samvandenabeele/CanSat/MARKDOWN.md

BMP280:
- I2C adress: 0x77
- C_max: 1.12 mA

RFM69HCW:
- 150 mA
- SPI:
	- RST: GP3
	- MOSI: GP7
	- MISO: GP6
	- SCK: GP4
	- NSS: GP5

MPU6050:
- I2C adress: 0x68
- C_max: 4 mA

TMP36:
- ADC: GP26
- C_max: 50 micro-A

SGP30:
- I2C adress: 0x58
- 50 mA

general I2C:
- I2C SDA: GP0
- I2C SCL: GP1

max battery current: 1 A
peak current draw: 955,12 mA
expected average current draw: 600-700 mA
