samvandenabeele/CanSat/cansat-pcb/cansat pcb.pdf

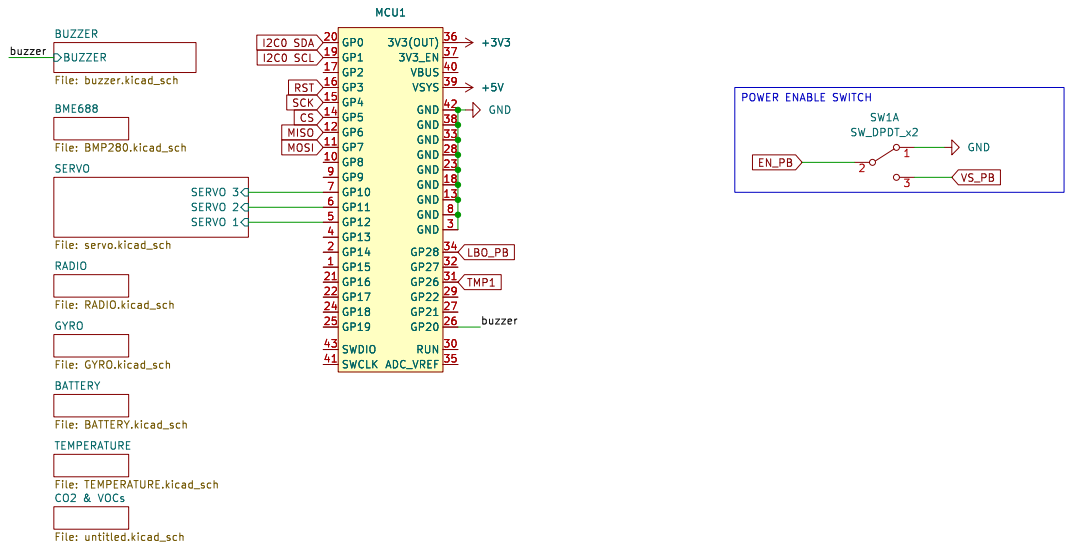
[picture p1: page 1]

I2C0 SDA RST SCK MISO
I2C0 SCL CS

File: RADIO.kicad_sch CO2 & VOCs File: untitled.kicad_sch BATTERY

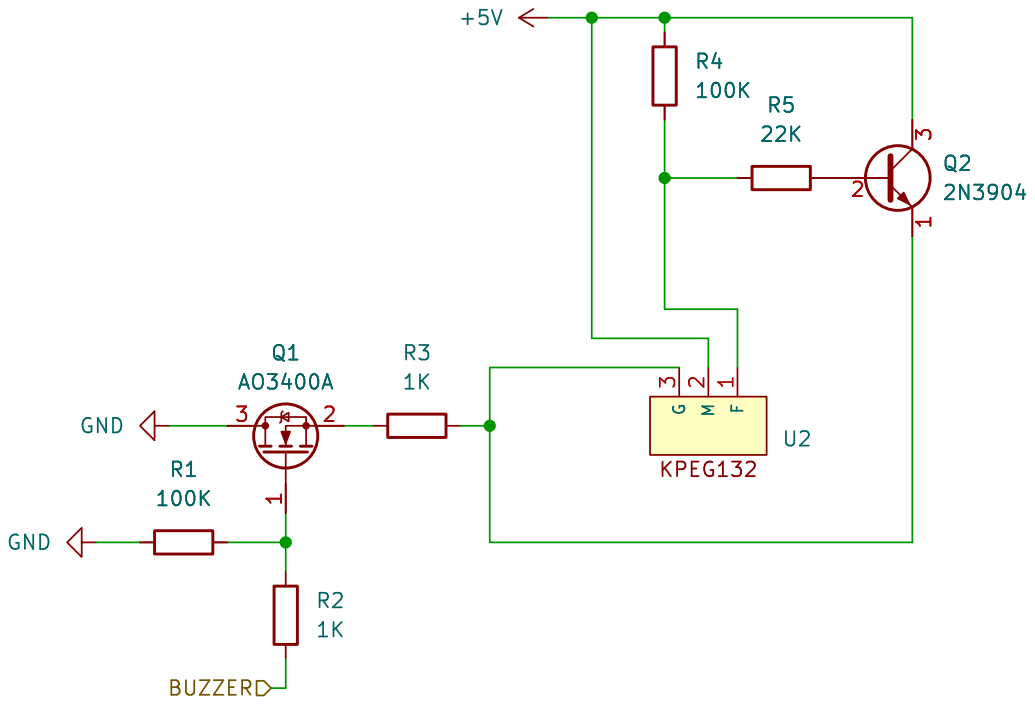
[picture p2: page 2]

Id: 2/9 Title: File: buzzer.kicad_sch Sheet: /BUZZER/

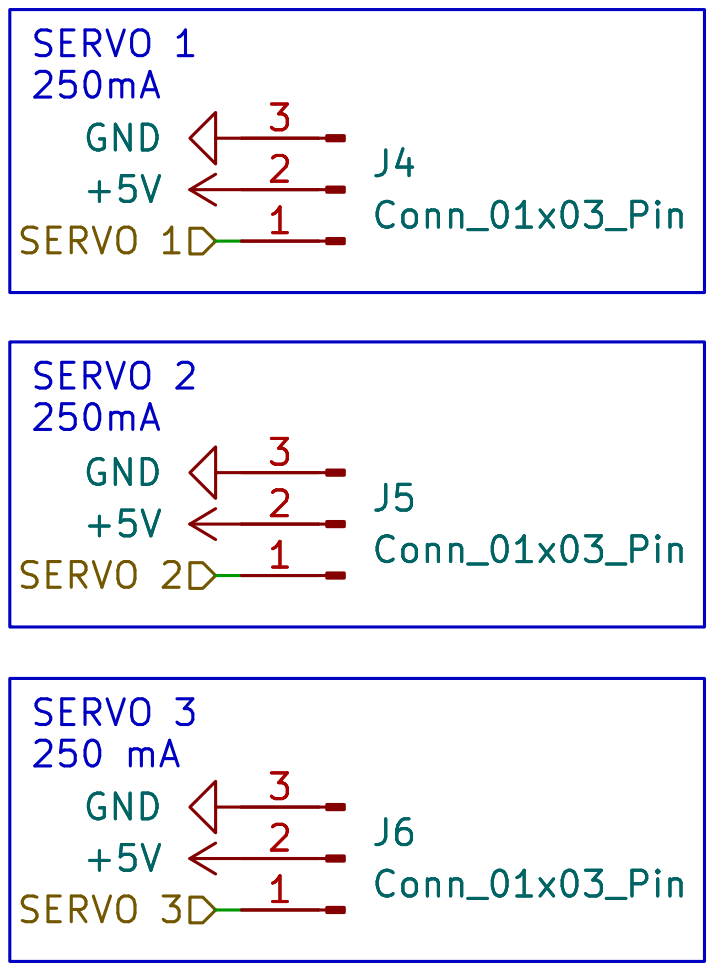
[picture p3: page 3]

J6Conn_01x03_Pin SERVO 1 SERVO 2 SERVO 3 SERVO 1

Id: 3/9 Title: File: servo.kicad_sch Sheet: /SERVO/

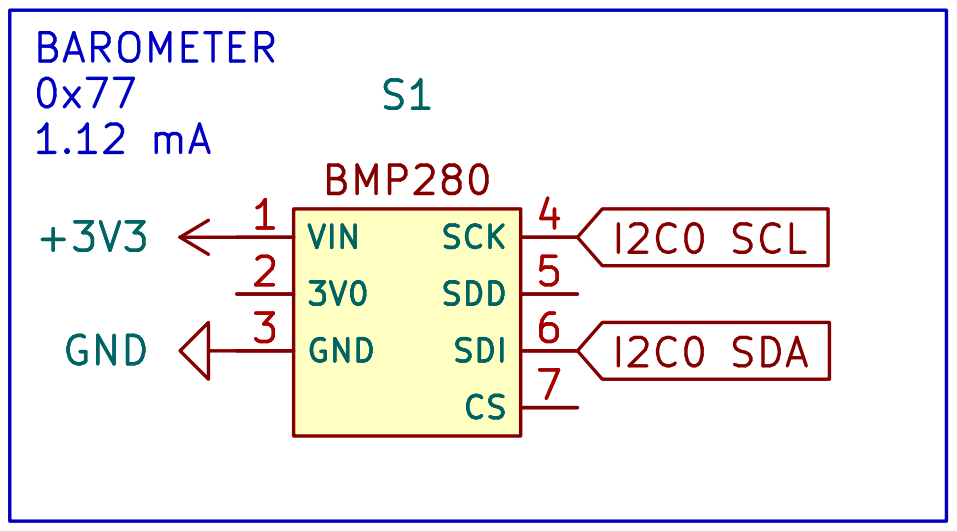
[picture p4: page 4]

Id: 4/9 Title: File: BMP280.kicad_sch Sheet: /BME688/ GND

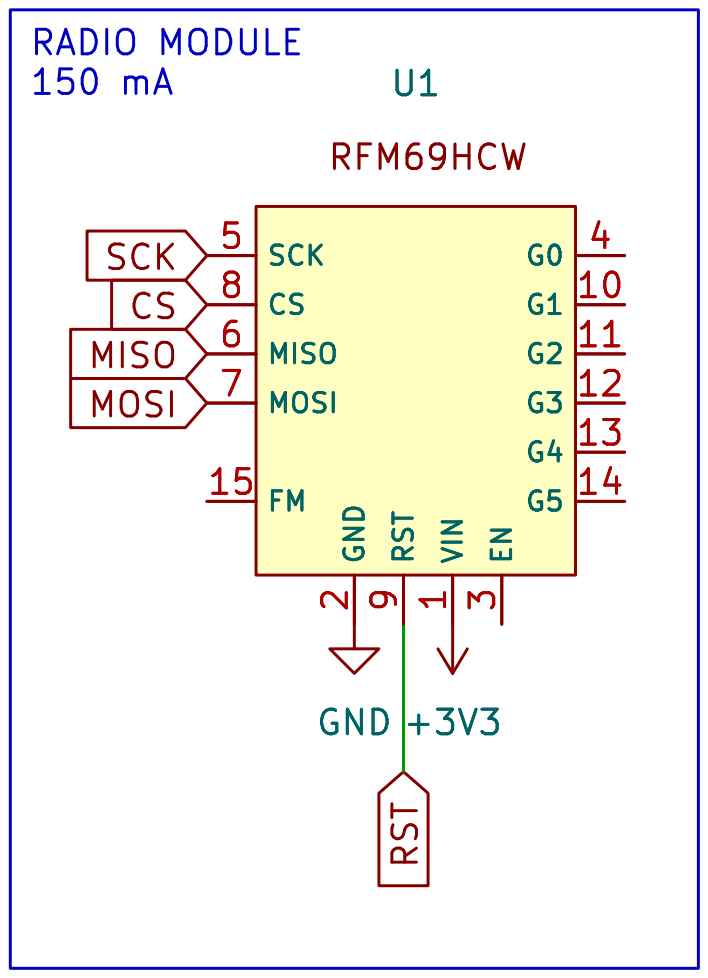
[picture p5: page 5]

CS MOSI RADIO MODULE

Id: 5/9 Title: File: RADIO.kicad_sch Sheet: /RADIO/ GND +3V3 RFM69HCWVIN

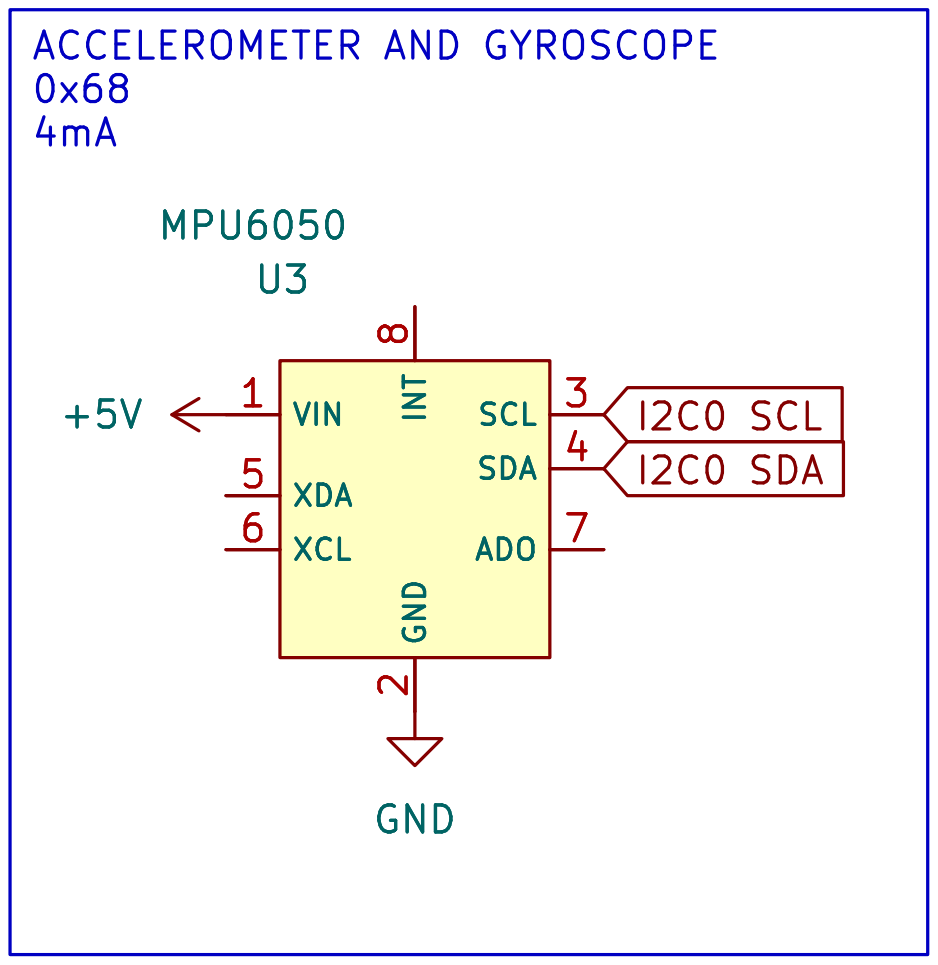
[picture p6: page 6]

I2C0 SCL ACCELEROMETER AND GYROSCOPE

Id: 6/9 Title: File: GYRO.kicad_sch Sheet: /GYRO/

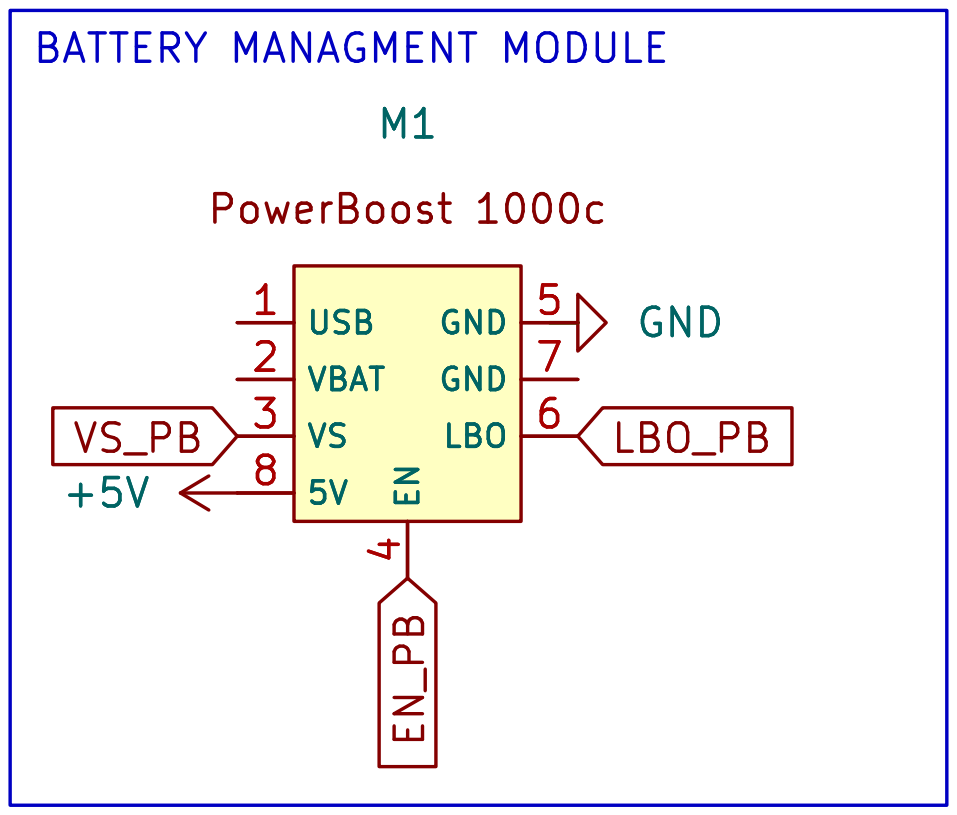
[picture p7: page 7]

BATTERY MANAGMENT MODULE M1 USB 1

Id: 7/9 Title: File: BATTERY.kicad_sch Sheet: /BATTERY/

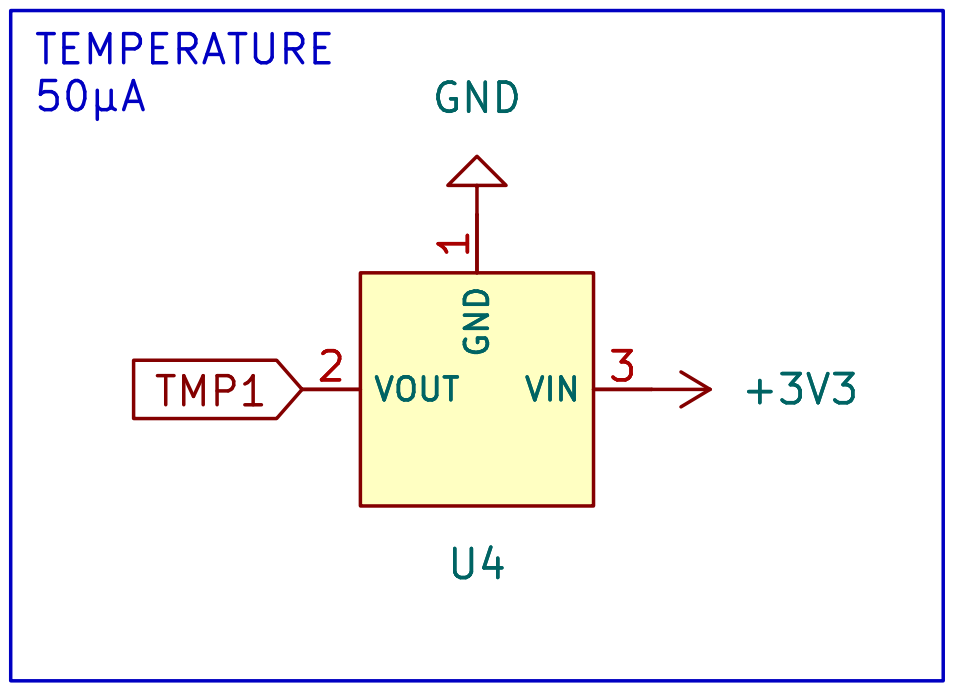
[picture p8: page 8]

Id: 8/9 Title: File: TEMPERATURE.kicad_sch Sheet: /TEMPERATURE/ GND

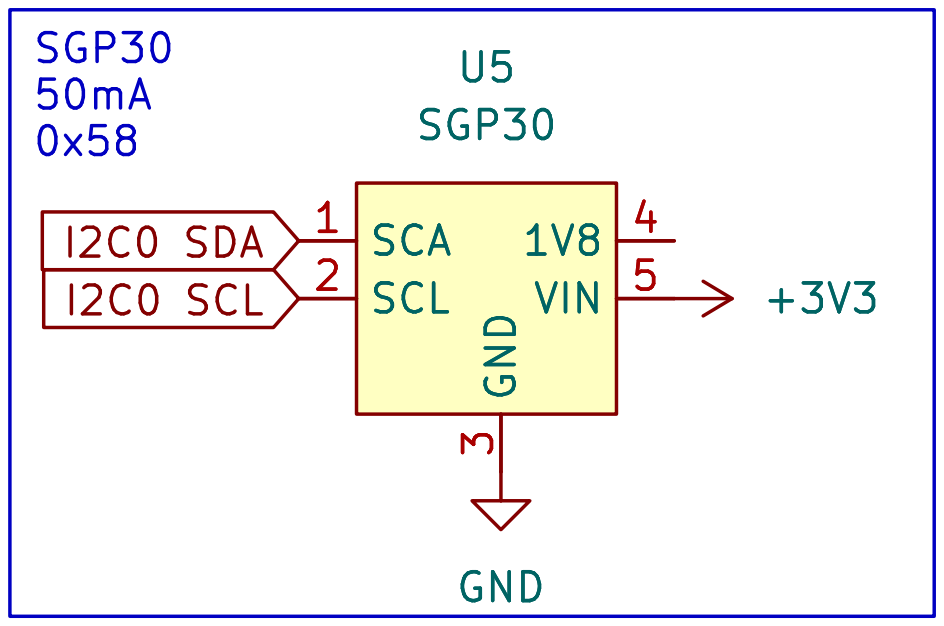
[picture p9: page 9]

Id: 9/9 Title: File: untitled.kicad_sch Sheet: /CO2 & VOCs/ GND
