samvandenabeele/CanSat/cansat-pcb/pcb_drawing_sheet.pdf

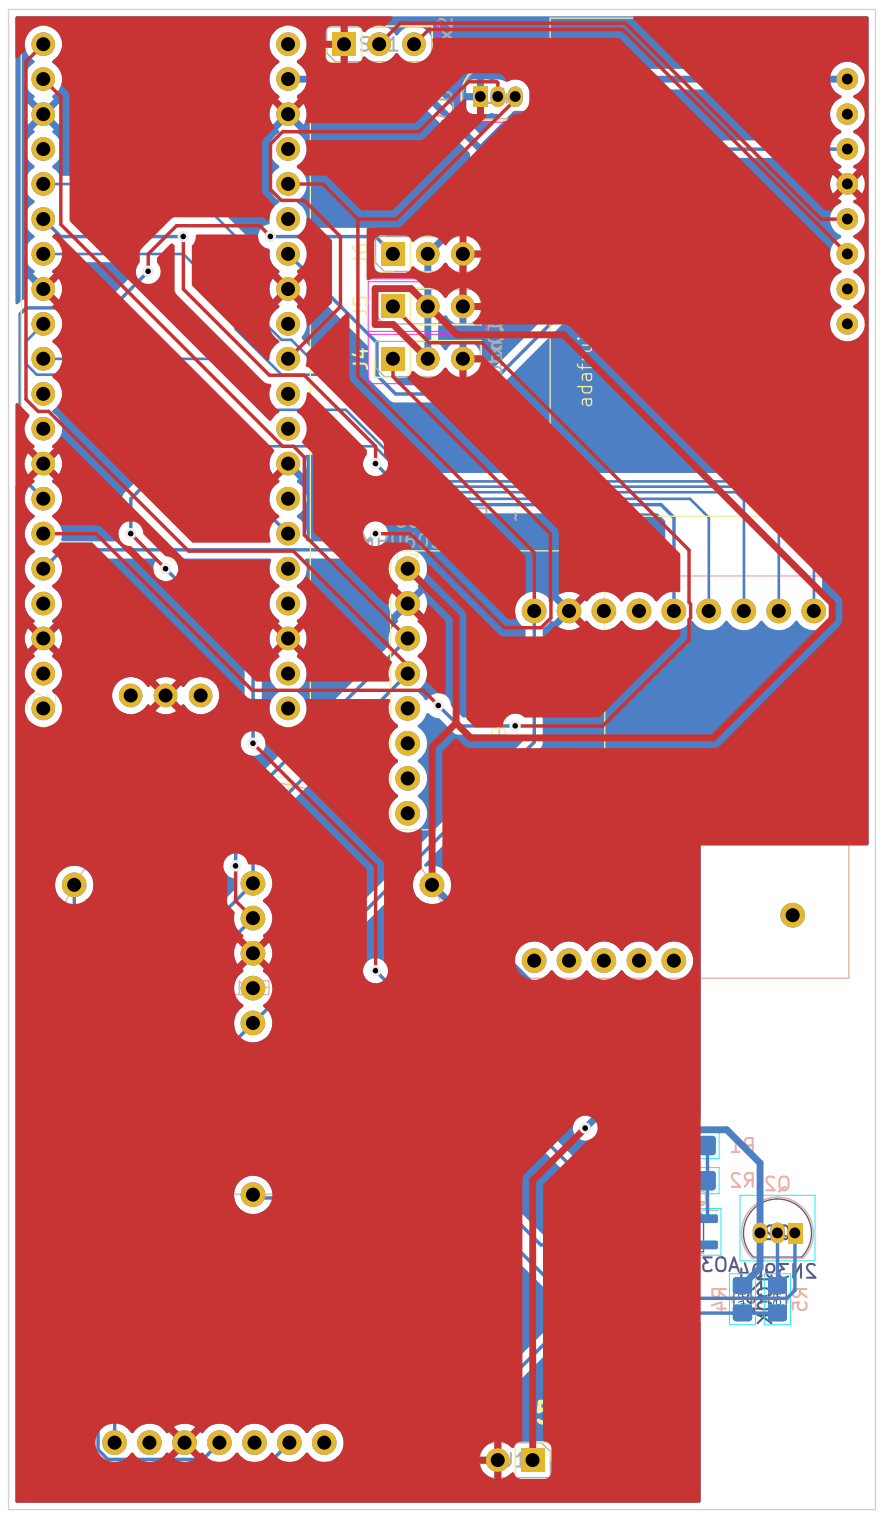
[picture p10: page 1]
