samvandenabeele/CanSat/cansat-pcb/cansat pcb.kicad_pcb

## KiCad design cansat-pcb/cansat pcb.kicad_pcb (2025-03-23)

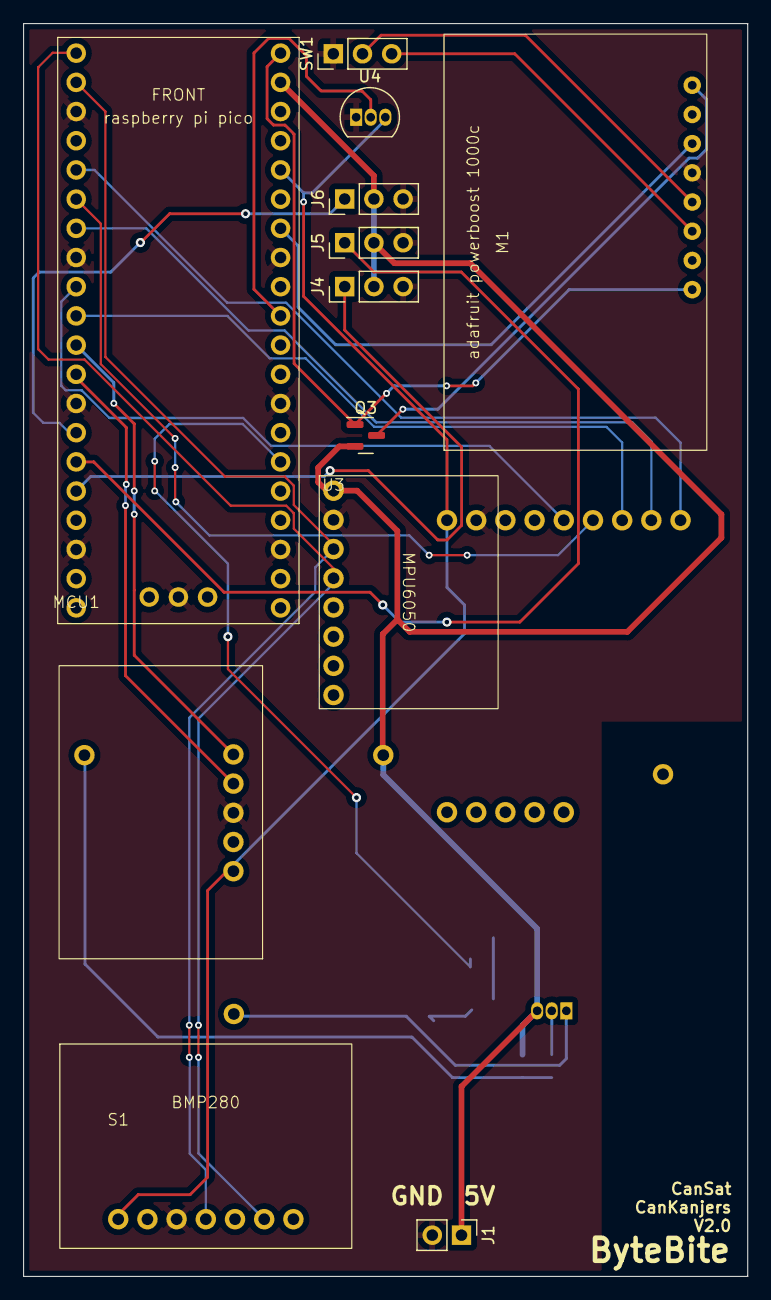
[picture p11: board cansat pcb.kicad_pcb from above]

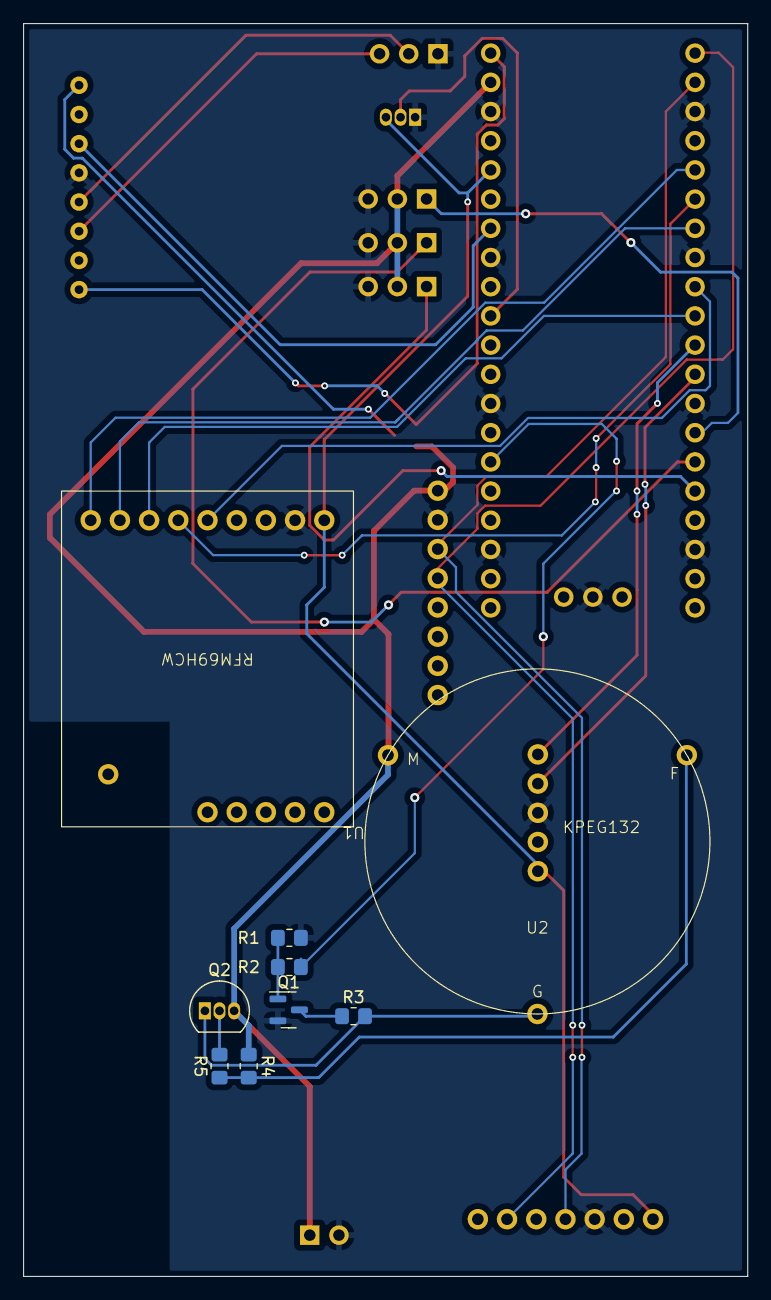
[picture p12: board cansat pcb.kicad_pcb from below]

Board: 2 copper layers, 63.0 x 109.0 mm, 21 parts (9 on the bottom side), 27 nets.

Parts:
J1: Conn_01x02_Pin; PinHeader_1x02_P2.54mm_Vertical
J4, J5, J6: Conn_01x03_Pin; PinHeader_1x03_P2.54mm_Vertical
M1: PowerBoost
MCU1: raspberry pi pico
Q1: AO3400A; SOT-23
Q2: 2N3904; TO-92_Inline
Q3: DMG2301L; SOT-23
R1, R4: 100K; R_0805_2012Metric_Pad1.20x1.40mm_HandSolder
R2, R3: 1K; R_0805_2012Metric_Pad1.20x1.40mm_HandSolder
R5: 22K; R_0805_2012Metric_Pad1.20x1.40mm_HandSolder
S1: BMP280
SW1: SW_DPDT_x2; PinHeader_1x03_P2.54mm_Vertical
U1: RFM69HCW
U2: KPEG132
U3: MPU6050
U4: TO-92L_Inline
U5: SGP30

Connections:
+3V3: MCU1.36 (3V3(OUT)), S1.1 (VIN), U1.1 (VIN), U4.3 (VIN), U5.1 (VIN)
+5V: J1.1, J4.2, J5.2, J6.2, MCU1.39 (VSYS), Q2.3 (C), Q3.2 (S), R4.1, U2.2 (M), U3.1 (VIN)
/SERVO/SERVO 1: J4.1, MCU1.16 (GP12)
/SERVO/SERVO 2: J5.1, MCU1.15 (GP11)
/SERVO/SERVO 3: J6.1, MCU1.14 (GP10)
/buzzer: MCU1.26 (GP20), R2.2
CS: MCU1.7 (GP5), U1.8 (CS)
EN_PB: M1.4 (EN), SW1.2 (B)
GND: J1.2, J4.3, J5.3, J6.3, M1.5 (GND), MCU1.3 (GND), MCU1.8 (GND), MCU1.13 (GND), MCU1.18 (GND), MCU1.23 (GND), MCU1.28 (GND), MCU1.33 (GND), MCU1.38 (GND), MCU1.42 (GND), Q1.2 (S), R1.1, S1.3 (GND), SW1.1 (A), U1.2 (GND), U3.2 (GND), U4.1 (GND), U5.3 (GND)
I2C0 SCL: MCU1.2 (GP1), S1.4 (SCK), U3.3 (SCL)
I2C0 SDA: MCU1.1 (GP0), S1.6 (SDI), U3.4 (SDA)
I2C1 SCL: MCU1.12 (GP9), U5.4 (SCL)
I2C1 SDA: MCU1.11 (GP8), U5.5 (SDA)
LBO_PB: M1.6 (LBO), MCU1.34 (GP28)
MISO: MCU1.6 (GP4), U1.6 (MISO)
MOSI: MCU1.10 (GP7), U1.7 (MOSI)
unnamed: M1.8 (5V), Q3.3 (D)
unnamed: Q1.3 (D), R3.1
unnamed: Q1.1 (G), R1.2, R2.1
unnamed: Q2.2 (B), R5.2
unnamed: Q2.1 (E), R3.2, U2.3 (G)
unnamed: R4.2, R5.1, U2.1 (F)
RST: MCU1.5 (GP3), U1.9 (RST)
SCK: MCU1.9 (GP6), U1.5 (SCK)
TMP1: MCU1.31 (GP26), U4.2 (VOUT)
VBUS: M1.1 (USB), MCU1.40 (VBUS), Q3.1 (G)
VS_PB: M1.3 (VS), SW1.3 (C)
