samvandenabeele/CanSat/(commit log)

2024-12-29 starting point
    [cansat pcb.kicad_pcb]
2025-01-04 Add sensor modules and update main script
    - Added new sensor modules: BMP280, MPU6050, RFM69
    - Deleted old BMP280_X.py file
    - Updated main.py to integrate new sensor modules
2025-01-05 Add MPU6050 sensor integration and RFM69 receive method
2025-01-05 LAATSTE VERSIE!!!!!!
    [BATTERY.kicad_sch, BMP280.kicad_sch, GYRO.kicad_sch, RADIO.kicad_sch, SGP30.kicad_sch, TEMPERATURE.kicad_sch, buzzer.kicad_sch, cansat pcb.kicad_sch]
2025-01-05 created MARKDOWN.md
    [BATTERY.kicad_sch, BMP280.kicad_sch, GYRO.kicad_sch, RADIO.kicad_sch, TEMPERATURE.kicad_sch, buzzer.kicad_sch, cansat pcb.kicad_sch, servo.kicad_sch]
2025-01-05 initialising Ground station
2025-01-08 sgp30 driver
2025-01-09 made some changes to pcb (fuck you Berenger)
    [cansat pcb.kicad_pcb, cansat pcb.kicad_sch, servo.kicad_sch, untitled.kicad_sch]
2025-01-12 Revert "Merge commit '673e45e53089288ec36ae3b7f805afa0fd734616'"
    This reverts commit 0ed28d3d5ac29bb0831e5b0937f54a526884ff85, reversing
    changes made to 753dbbe2e9bb9dc030257394465552912bba7aea.
    [GYRO.kicad_sch, SGP30.kicad_sch, cansat pcb.kicad_sch, servo.kicad_sch, untitled.kicad_sch]
2025-01-12 pcb done
    [cansat pcb.kicad_pcb]
2025-01-16 pcb desing + TMP36 class
    [cansat pcb.kicad_pcb]
2025-03-22 pcb V2
    [buzzer.kicad_sch, cansat pcb.kicad_sch, untitled.kicad_sch]
2025-04-01 groundstation test code
2025-04-01 simplify packet reception logging by removing unnecessary print statements
2025-04-01 add bootstrap script and new libraries for servo and vector3d functionality
2025-04-14 add initial PCB design file for CanSat components
    [cansat pcb.csv]
2025-04-14 created a program that listens for the receiving pico to print something and then plots that data in a graph
2025-04-18 Dago doet iets (wss nog steeds slecht)
    1. in Main, kleine filter opgesteld voor het versturen van de data
    2. in ground station, Kalman filter opgesteld (kan zeker fout zijn, moet nog eens deftig naar gekeken worden, ik ben géén pro.
    3. plots ingesteld, daar kijk ik wel nog eens naar met meneer Vanholme, hij heeft veel ervaring.
    -> er zitten ongetwijfeld fouten in ,maar toch zeg het als je iets verandert, zo leer ik ook hé =)
2025-04-20 delete the plotting code that was not properly located. To make sure this does not happen again, I request that you learn to use issues and pull requests on GitHub. This will help us keep track of ch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
    @Dagorius
    [main.py]
